daapavlov/ServoDronCAN/Паспорт.docx

| | | | | | | | ИП Воронков
| Комплект управления сервоприводом

# 1. Основные требования

  1.1 Комплект управления предназначен для взаимодействия испытателя с сервоприводом в условиях стендовых испытаний по средствам изменения положения аналоговой ручки.
  1.2 Комплект состоит из двух устройств: 1 – блок питания, который следует располагать вблизи сервопривода; 2 – пульт управления с цифровым индикатором, который следует располагать на расстоянии не более 10 м от блока питания, для дистанционного осуществления управления сервоприводом.

# 2. Технические характеристики

| Блок питания | Пульт управления
Напряжение питания постоянного тока, В | 10-36 | 5
Макс. ток потребления, А | 6 | 0.5
Интерфейс обмена данными | CAN | CAN
Интерфейс управления внешним устройством | CAN, servo PWM | -
Сигнал в измерительную систему | аналоговый 0-10 В, частотный 100-1000 Гц (открытый коллектор 10мА) | -
Защита от неправильного подключения питания | + | -

# 3. Внешний вид устройства
