daapavlov/ServoDronCAN/ServoDronCAN.png

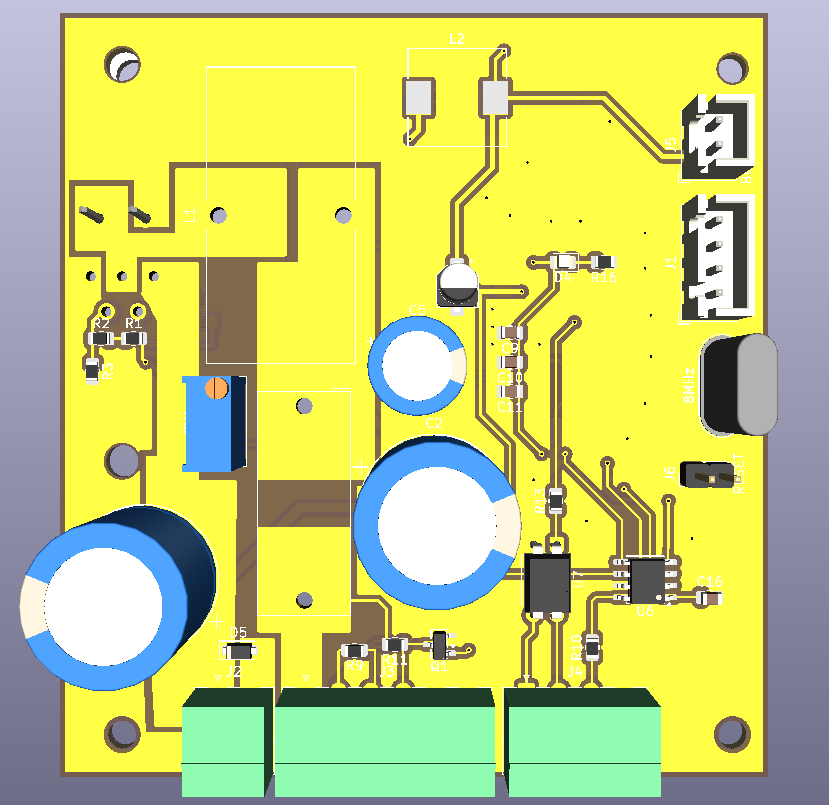
ServoDronCAN.png
