daapavlov/ServoDronCAN/Handheld remote control/Handheld remote control/2d_BUA.step

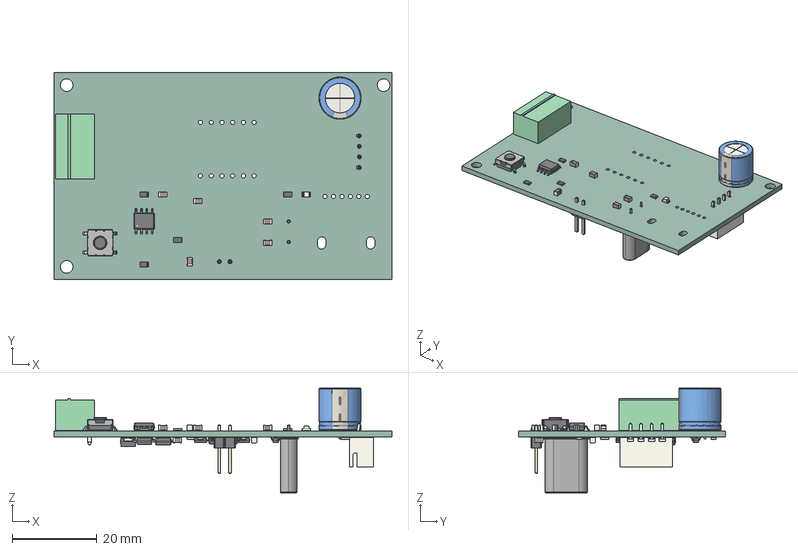
[picture p2: CAD file, 2026-10-22]
Handheld remote control/Handheld remote control/2d_BUA.step
80.0 x 49.0 x 24.8 mm
PhoenixContact_MC_1,5_4-G-3.5_1x04_P3.50mm_Horizontal
C_0805_2012Metric x 9
SW_SPST_Omron_B3FS-100xP
R_0805_2012Metric x 18
SOIC-8_3.9x4.9mm_P1.27mm
LED_0805_2012Metric
CP_Radial_D10.0mm_P2.50mm
Crystal_HC49-U_Vertical
SOT-23 x 4
D_SMB
LQFP-48_7x7mm_P0.5mm
SOIC-16_3.9x9.9mm_P1.27mm
SOT-223
PinHeader_1x02_P2.54mm_Vertical
JST_XH_B4B-XH-A_1x04_P2.50mm_Vertical
Handheld remote control_PCB
