daapavlov/ServoDronCAN/(list of files, cad)

Other CAD files:
Handheld remote control/Handheld remote control/2d_BUA.ply
Handheld remote control/Handheld remote control/2d_BUA.stl
