daapavlov/ServoDronCAN/Электрическая схема.pdf

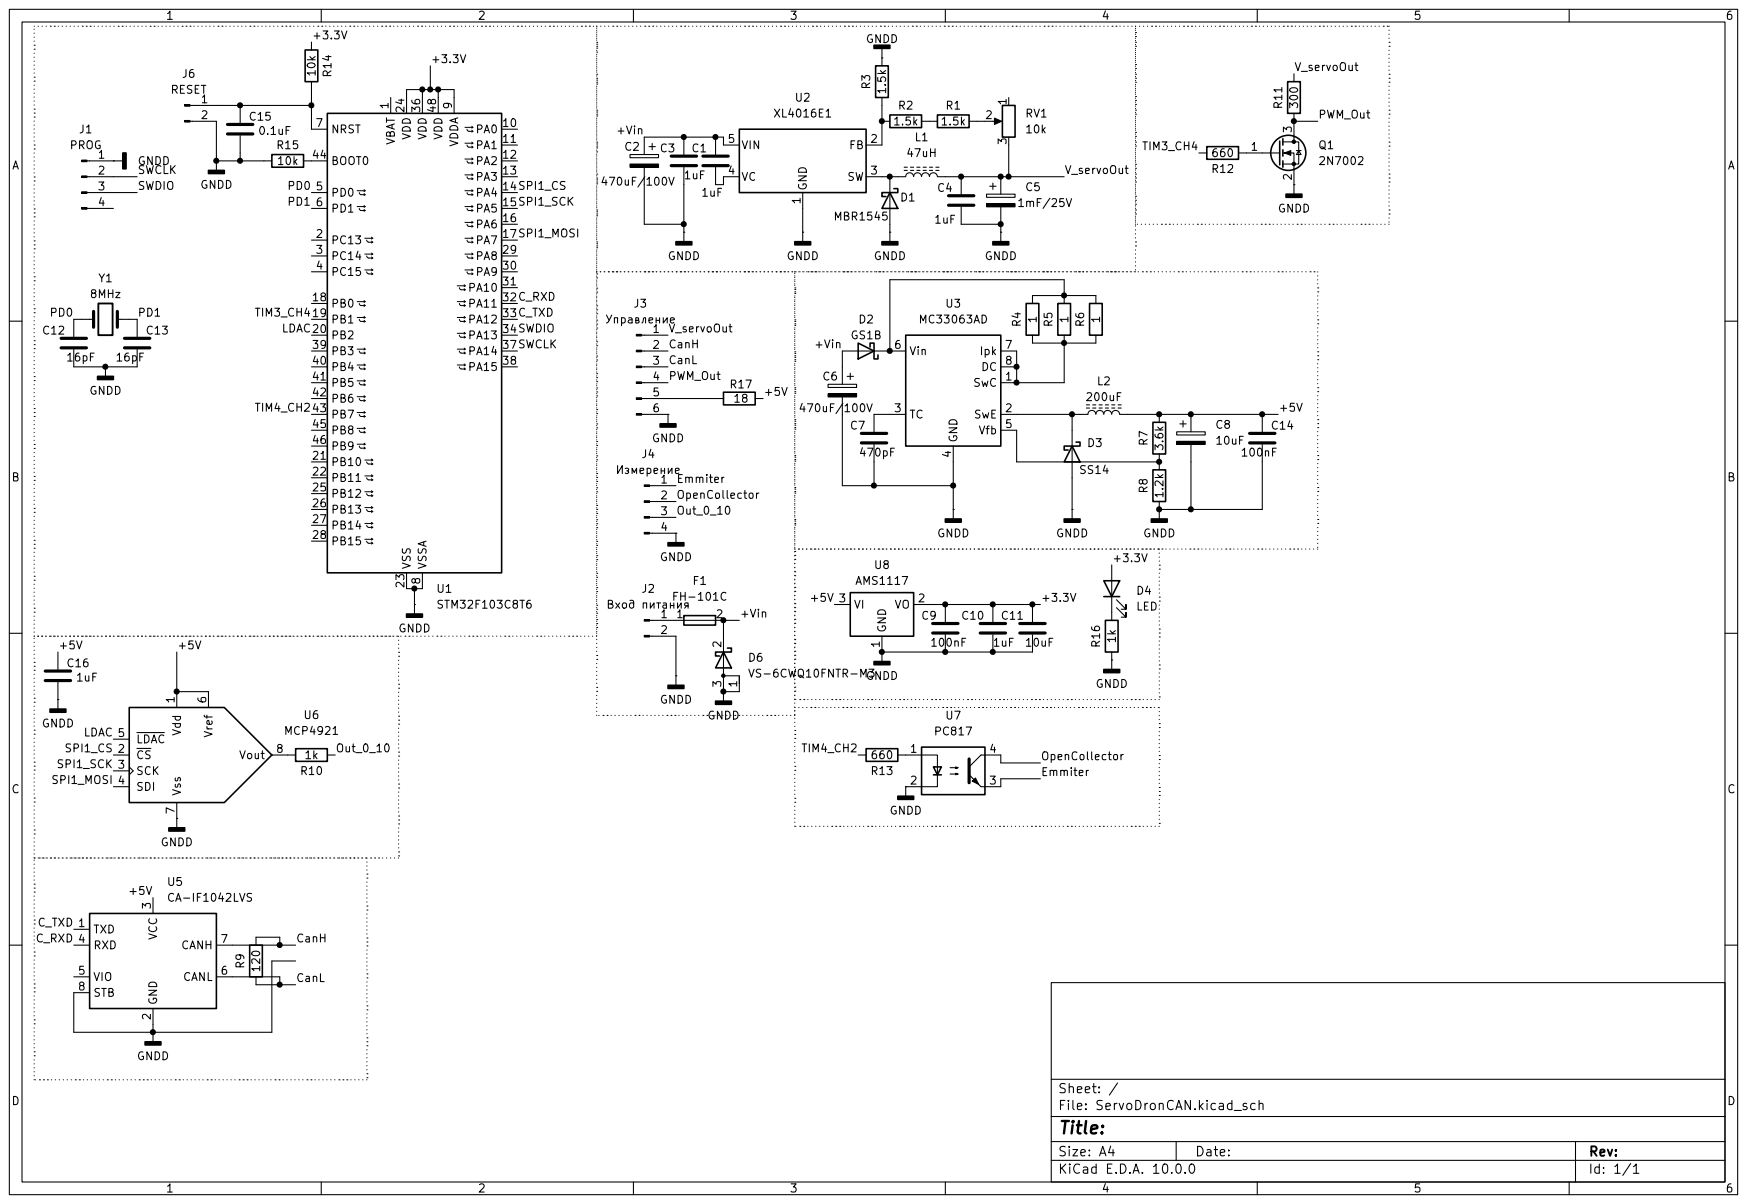
[picture p3: page 1]
