daapavlov/ServoDronCAN/ServoDronCAN/Схема электрическая БПУ.pdf

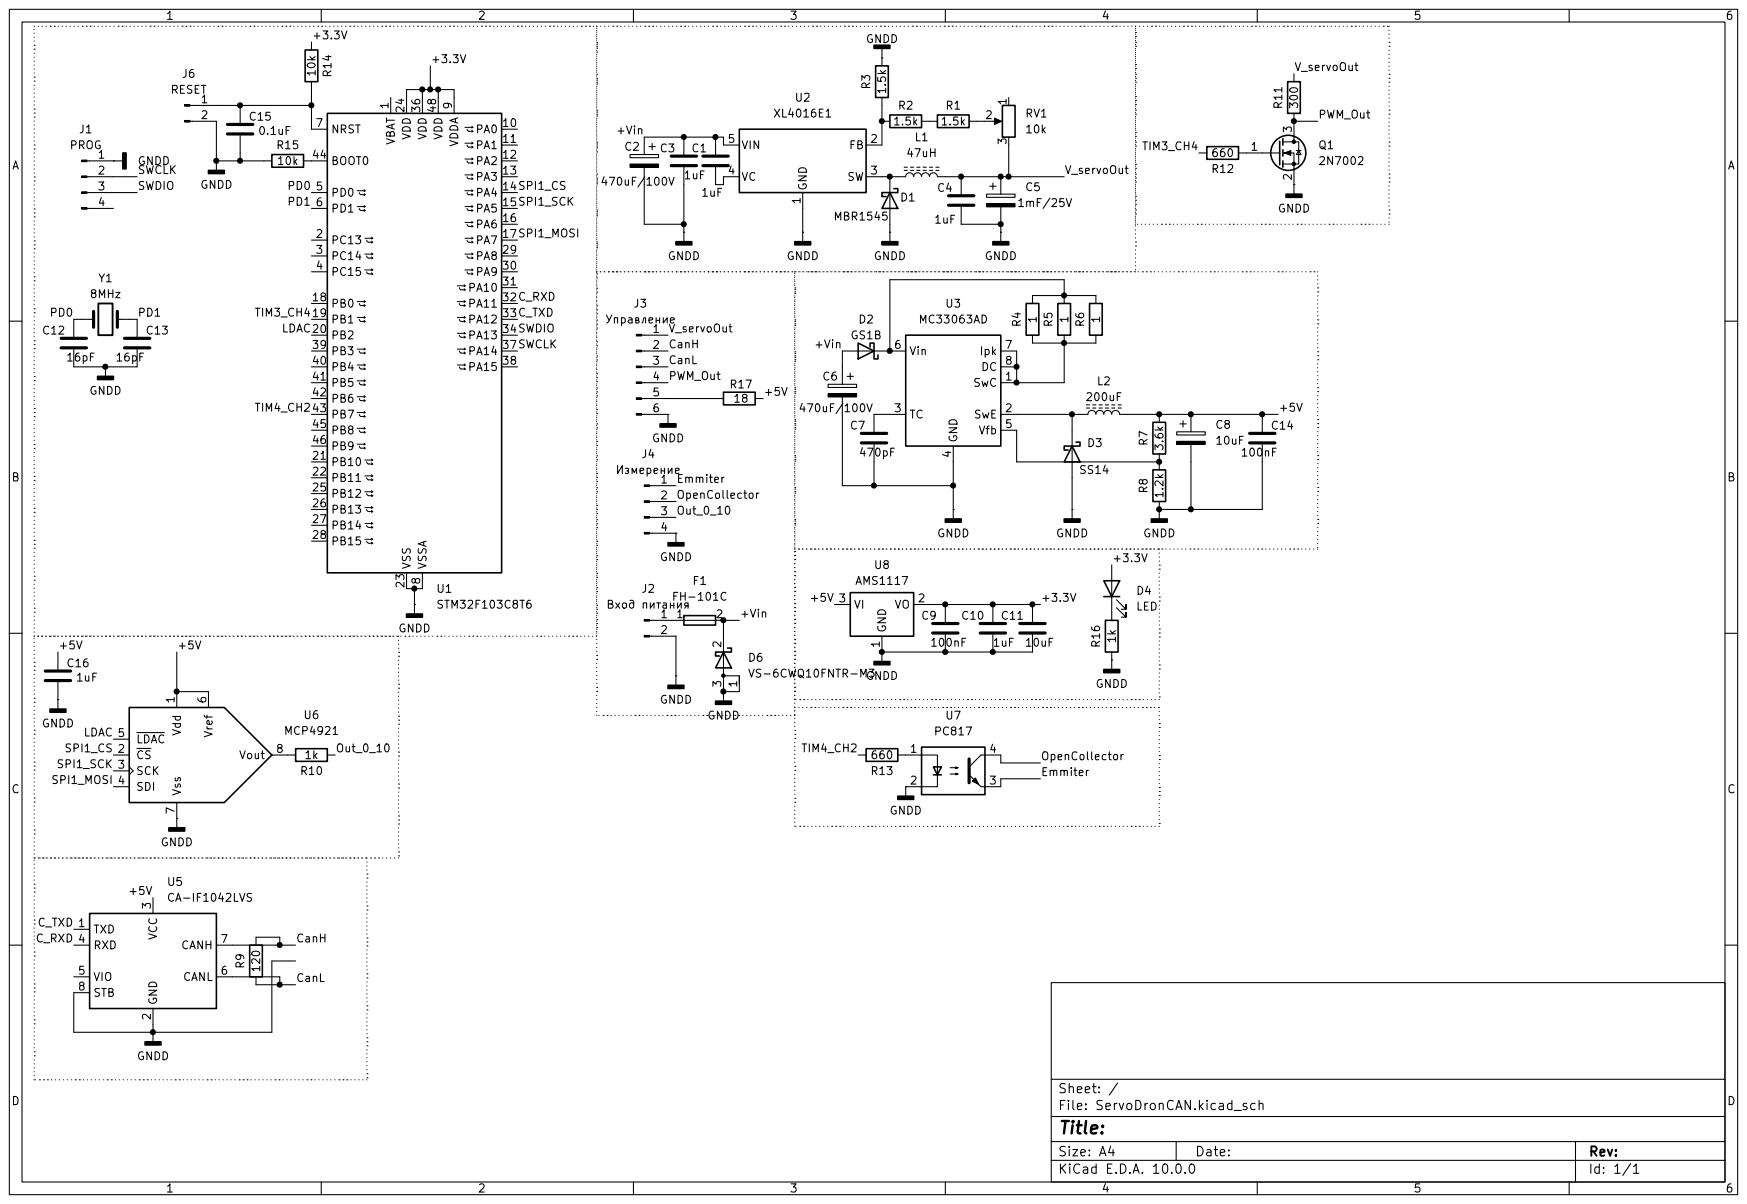
[picture p4: page 1]
