daapavlov/ServoDronCAN/Handheld remote control/Handheld remote control/Схема электрическая ПУ.pdf

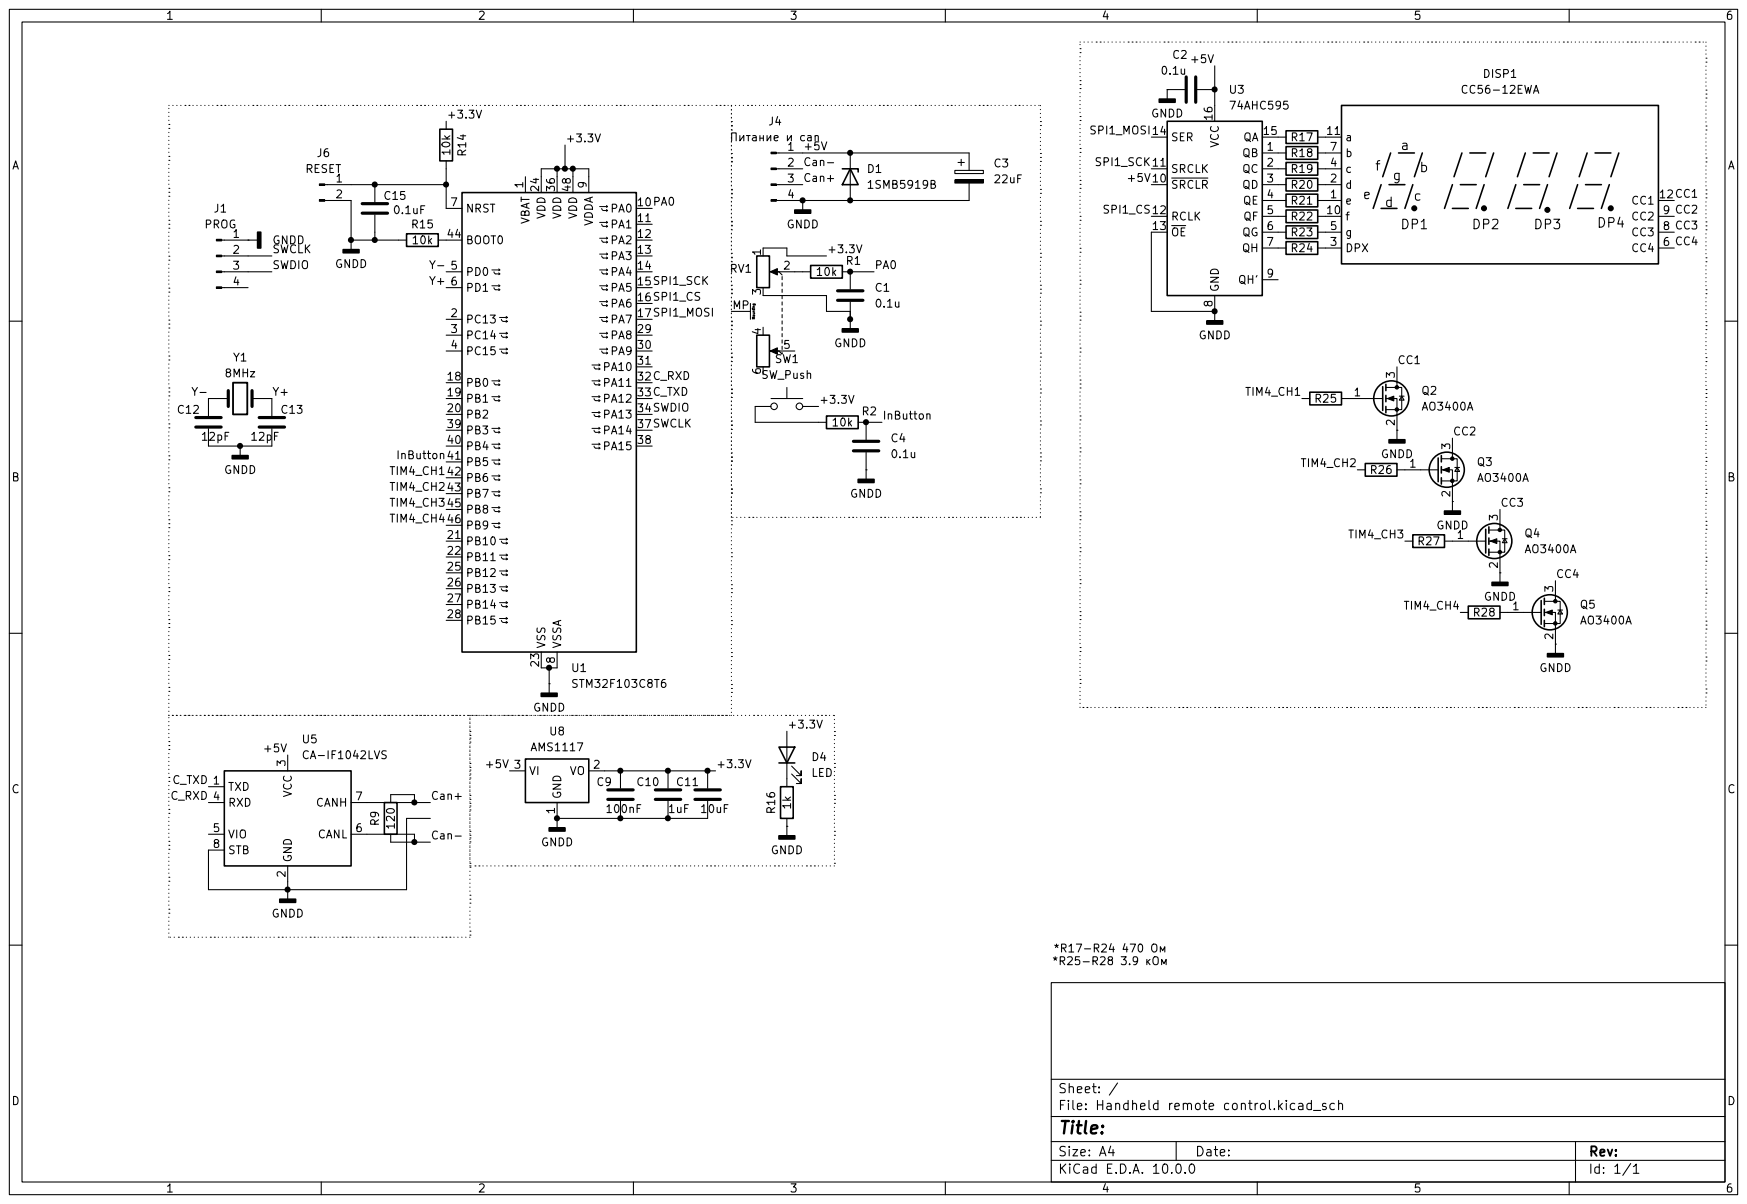
[picture p5: page 1]
