daapavlov/ServoDronCAN/Handheld remote control/Handheld remote control/Handheld remote control.kicad_pcb

## KiCad design Handheld remote control/Handheld remote control/Handheld remote control.kicad_pcb (2026-10-22)

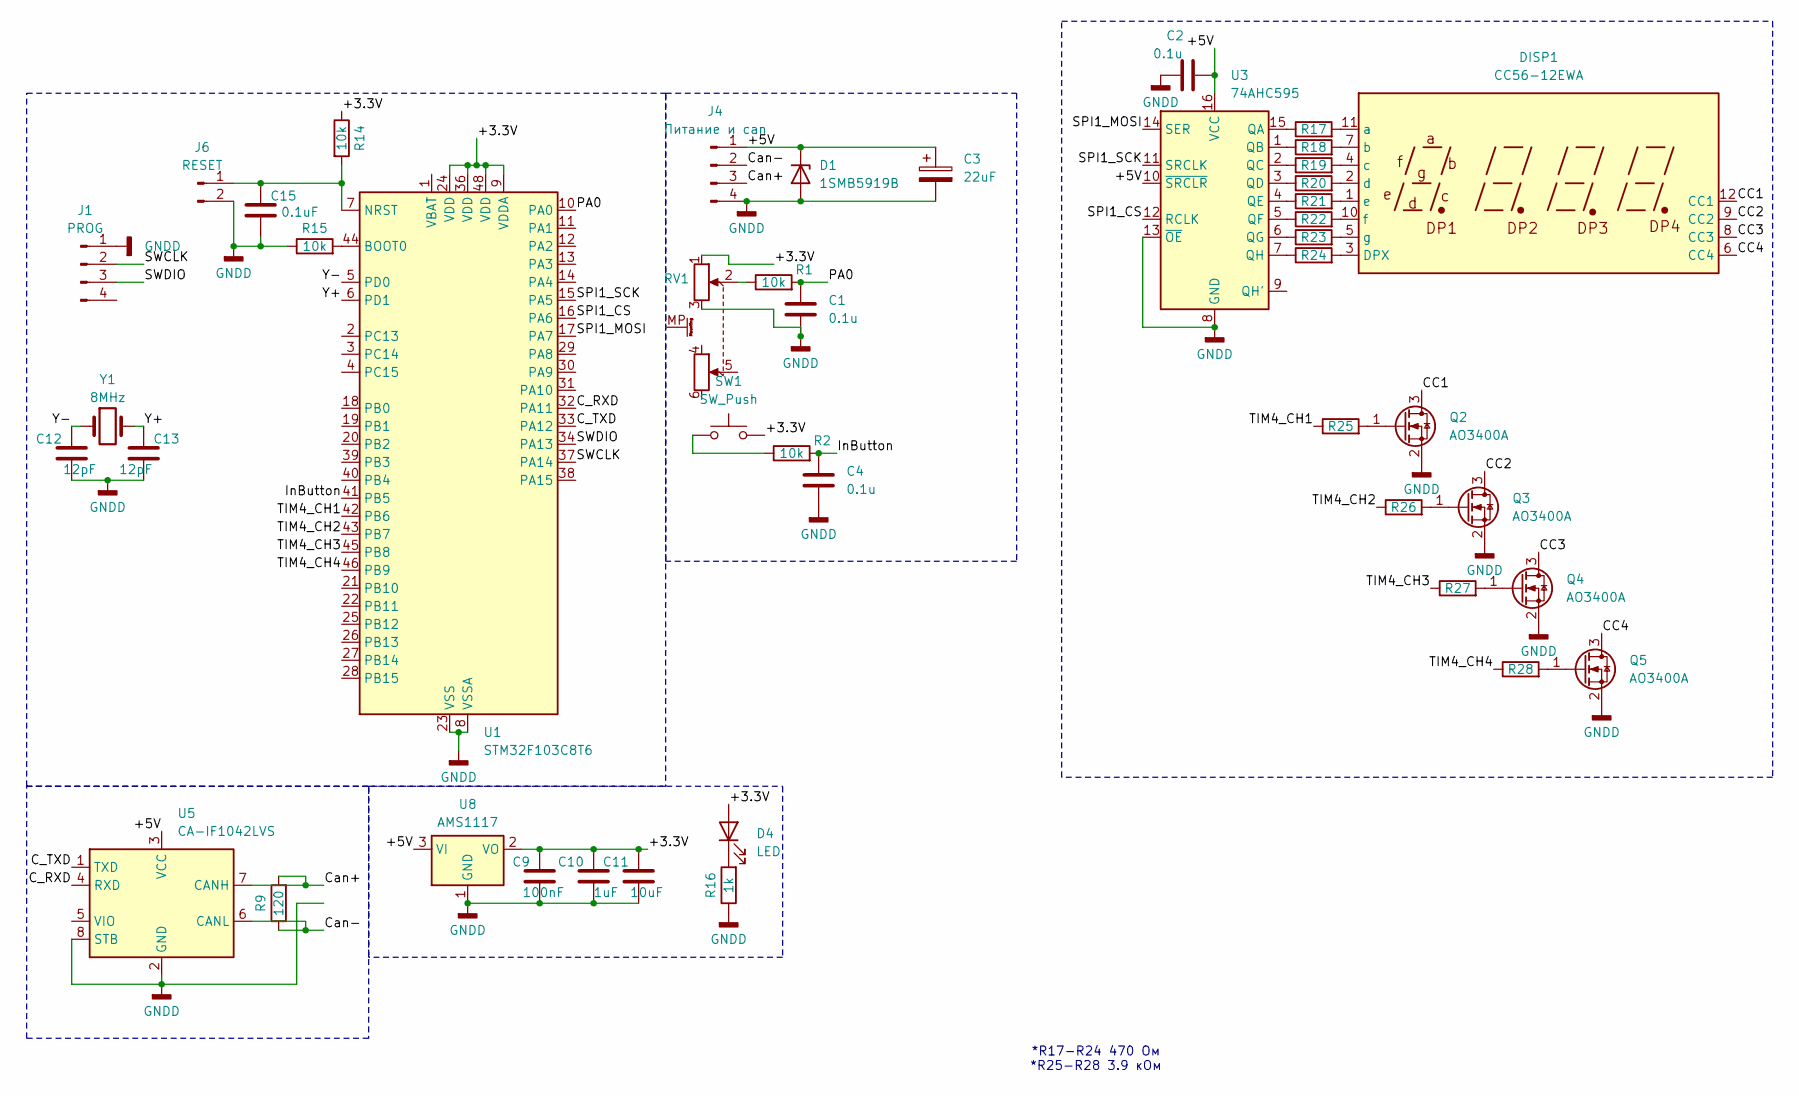
[picture p6: schematic Handheld remote control.kicad_sch]

Parts:
C1, C2, C4: 0.1u; C_0805_2012Metric_Pad1.18x1.45mm_HandSolder
C3: 22uF; CP_Radial_D10.0mm_P2.50mm
C9: 100nF; C_0805_2012Metric
C10: 1uF; C_0805_2012Metric
C11: 10uF; C_0805_2012Metric
C12, C13: 12pF; C_0805_2012Metric
C15: 0.1uF; C_0805_2012Metric
D1: 1SMB5919B; D_SMB
D4: LED; LED_0805_2012Metric
DISP1: CC56-12EWA; CA56-12EWA
J1: PROG; JST_XH_B4B-XH-A_1x04_P2.50mm_Vertical
J4: Питание и can; PhoenixContact_MC_1,5_4-G-3.5_1x04_P3.50mm_Horizontal
J6: RESET; PinHeader_1x02_P2.54mm_Vertical
Q2, Q3, Q4, Q5: AO3400A; SOT-23
R1, R2, R14, R15: 10k; R_0805_2012Metric
R9: 120; R_0805_2012Metric
R16: 1k; R_0805_2012Metric
R17, R18, R19, R20, R21, R22, R23, R24: 470; R_0805_2012Metric
R25, R26, R27, R28: 3.3k; R_0805_2012Metric
RV1: R_Potentiometer_Dual_MountingPin; Potentiometer_Bourns_PTV112-4_Dual_Vertical
SW1: SW_Push; SW_SPST_Omron_B3FS-100xP
U1: STM32F103C8T6; LQFP-48_7x7mm_P0.5mm; Operating Voltage Range 2V~3.6V; Low Voltage Detection T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 2V~3.6V; Part STM32F103C8T6; LCSC C8734
U3: 74AHC595; SOIC-16_3.9x9.9mm_P1.27mm
U5: CA-IF1042LVS; SOIC-8_3.9x4.9mm_P1.27mm
U8: AMS1117; SOT-223-3_TabPin2
Y1: 8MHz; Crystal_HC49-U_Vertical

Connections:
/+3.3V: C9.1, C10.1, C11.1, D4.2 (A), R14.1, RV1.1, SW1.2, U1.9 (VDDA), U1.24 (VDD), U1.36 (VDD), U1.48 (VDD), U8.2 (VO)
/+5V: C2.2, C3.1, D1.1 (K), J4.1, U3.10 (~SRCLR), U3.16 (VCC), U5.3 (VCC), U8.3 (VI)
/C_RXD: U1.32 (PA11), U5.4 (RXD)
/C_TXD: U1.33 (PA12), U5.1 (TXD)
/Can+: J4.3, R9.2, U5.7 (CANH)
/Can-: J4.2, R9.1, U5.6 (CANL)
/InButton: C4.1, R2.2, U1.41 (PB5)
/PA0: C1.1, R1.2, U1.10 (PA0)
/SPI1_CS: U1.16 (PA6), U3.12 (RCLK)
/SPI1_MOSI: U1.17 (PA7), U3.14 (SER)
/SPI1_SCK: U1.15 (PA5), U3.11 (SRCLK)
/SWCLK: J1.2, U1.37 (PA14)
/SWDIO: J1.3, U1.34 (PA13)
/TIM4_CH1: R25.1, U1.42 (PB6)
/TIM4_CH2: R26.1, U1.43 (PB7)
/TIM4_CH3: R27.1, U1.45 (PB8)
/TIM4_CH4: R28.1, U1.46 (PB9)
/Y+: C13.1, U1.6 (PD1), Y1.2
/Y-: C12.1, U1.5 (PD0), Y1.1
/СС1: DISP1.12 (CC1), Q2.3 (D)
/СС2: DISP1.9 (CC2), Q3.3 (D)
/СС3: DISP1.8 (CC3), Q4.3 (D)
/СС4: DISP1.6 (CC4), Q5.3 (D)
GNDD: C1.2, C2.1, C3.2, C4.2, C9.2, C10.2, C11.2, C12.2, C13.2, C15.2, D1.2 (A), J1.1, J4.4, J6.2, Q2.2 (S), Q3.2 (S), Q4.2 (S), Q5.2 (S), R15.1, R16.1, RV1.3, U1.8 (VSSA), U1.23 (VSS), U1.35 (VSS), U1.47 (VSS), U3.8 (GND), U3.13 (~OE), U5.2 (GND), U5.8 (STB), U8.1 (GND)
unnamed: D4.1 (K), R16.2
unnamed: DISP1.3 (DPX), R24.2
unnamed: DISP1.11 (a), R17.2
unnamed: DISP1.7 (b), R18.2
unnamed: DISP1.4 (c), R19.2
unnamed: DISP1.2 (d), R20.2
unnamed: DISP1.1 (e), R21.2
unnamed: DISP1.10 (f), R22.2
unnamed: DISP1.5 (g), R23.2
unnamed: C15.1, J6.1, R14.2, U1.7 (NRST)
unnamed: Q2.1 (G), R25.2
unnamed: Q3.1 (G), R26.2
unnamed: Q4.1 (G), R27.2
unnamed: Q5.1 (G), R28.2
unnamed: R1.1, RV1.2
unnamed: R2.1, SW1.1
unnamed: R15.2, U1.44 (BOOT0)
unnamed: R17.1, U3.15 (QA)
unnamed: R18.1, U3.1 (QB)
unnamed: R19.1, U3.2 (QC)
unnamed: R20.1, U3.3 (QD)
unnamed: R21.1, U3.4 (QE)
unnamed: R22.1, U3.5 (QF)
unnamed: R23.1, U3.6 (QG)
unnamed: R24.1, U3.7 (QH)

Notes on the sheet:
*R17-R24 470 Ом *R25-R28 3.9 кОм

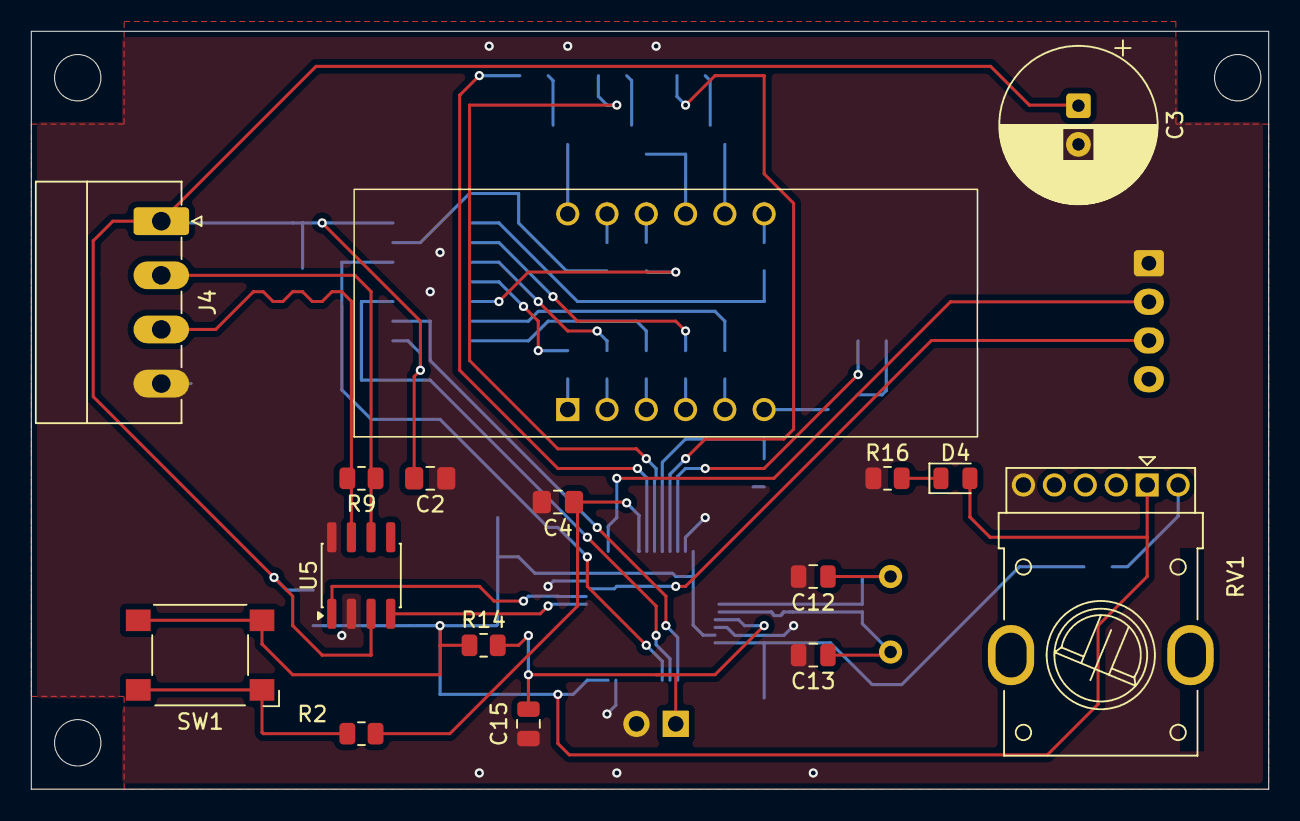
[picture p7: board Handheld remote control.kicad_pcb from above]

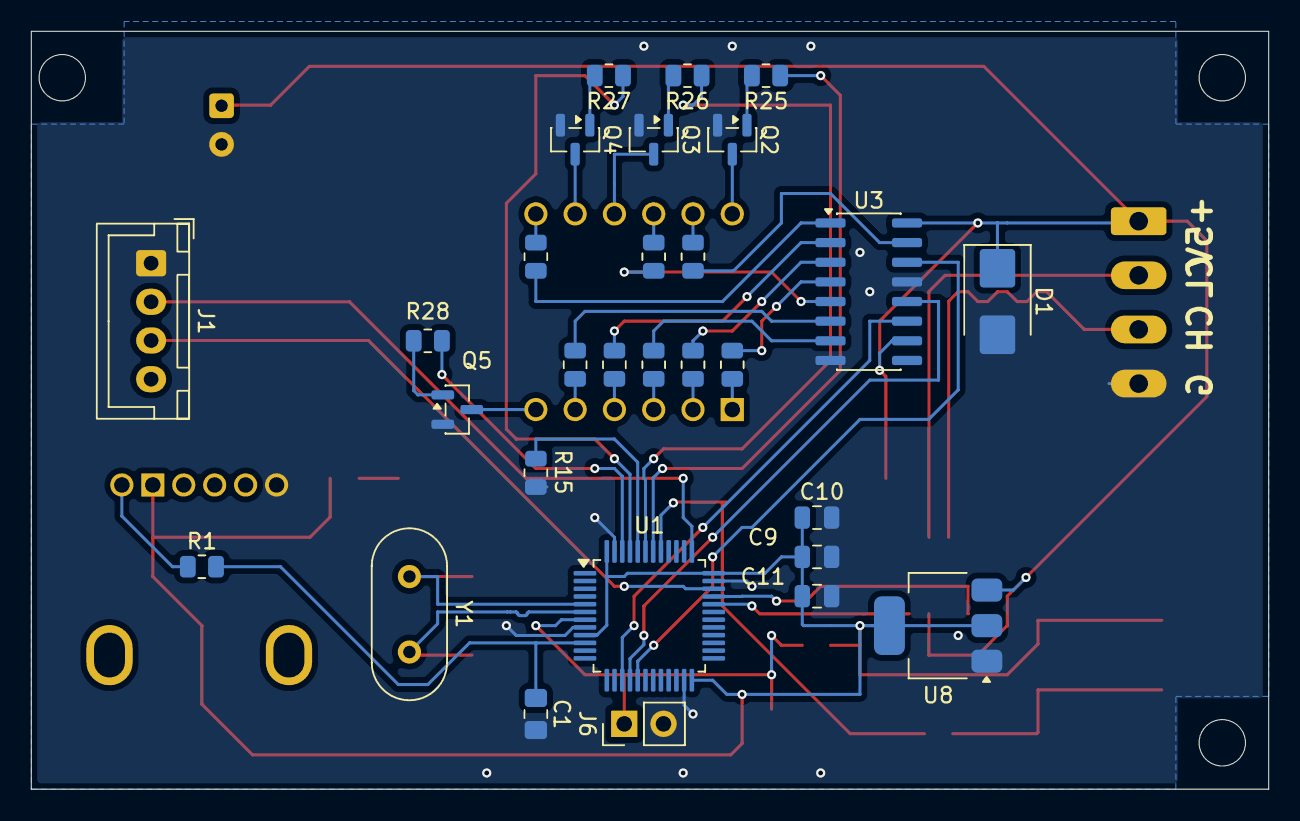
[picture p8: board Handheld remote control.kicad_pcb from below]

Board: 2 copper layers, 80.0 x 49.0 mm, 45 parts (29 on the bottom side), 49 nets.
