daapavlov/ServoDronCAN/ServoDronCAN/ServoDronCAN.kicad_pcb

## KiCad design ServoDronCAN/ServoDronCAN.kicad_pcb (2026-09-30)

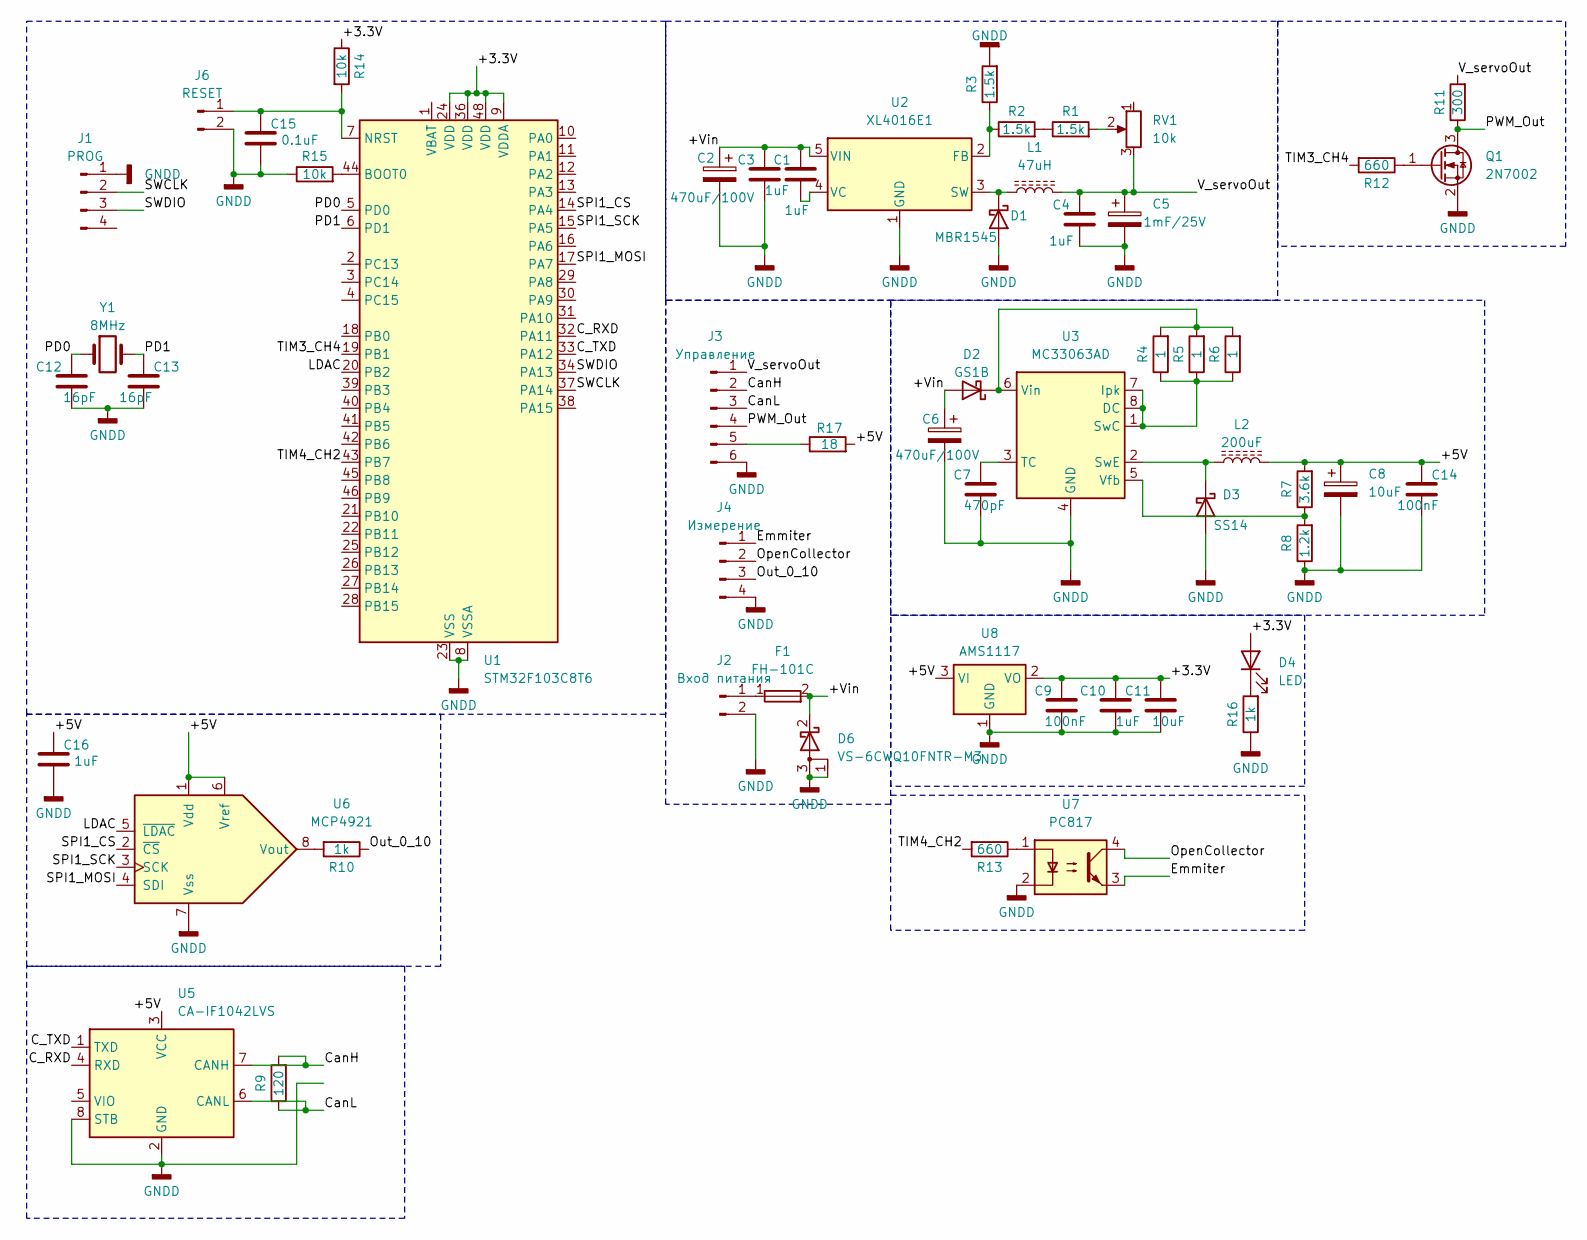
[picture p9: schematic ServoDronCAN.kicad_sch]

Parts:
C1, C3, C4, C10, C16: 1uF; C_0805_2012Metric
C2, C6: 470uF/100V; CP_Radial_D16.0mm_P7.50mm
C5: 1mF/25V; CP_Radial_D10.0mm_P5.00mm
C7: 470pF; C_0805_2012Metric
C8: 10uF; CP_Elec_4x5.4
C9, C14: 100nF; C_0805_2012Metric
C11: 10uF; C_0805_2012Metric
C12, C13: 16pF; C_0805_2012Metric
C15: 0.1uF; C_0805_2012Metric
D1: MBR1545; TO-220-2_Horizontal_TabUp
D2: GS1B; D_SMA
D3: SS14; D_SMA
D4: LED; LED_0805_2012Metric
D6: VS-6CWQ10FNTR-M3; TO-252-2
F1: FH-101C
J1: PROG; JST_XH_B4B-XH-A_1x04_P2.50mm_Vertical
J2: Вход питания; PhoenixContact_MC_1,5_2-G-3.5_1x02_P3.50mm_Horizontal
J3: Управление; PhoenixContact_MC_1,5_6-G-3.5_1x06_P3.50mm_Horizontal
J4: Измерение; PhoenixContact_MC_1,5_4-G-3.5_1x04_P3.50mm_Horizontal
J6: RESET; PinHeader_1x02_P2.54mm_Vertical
L1: 47uH; L_Toroid_Vertical_L31.8mm_W15.9mm_P13.50mm_Bourns_5700
L2: 200uF; L_10.4x10.4_H4.8
Q1: 2N7002; SOT-23-3
R1, R2, R3: 1.5k; R_0805_2012Metric
R4, R5, R6: 1; R_0805_2012Metric
R7: 3.6k; R_0805_2012Metric
R8: 1.2k; R_0805_2012Metric
R9: 120; R_0805_2012Metric
R10, R16: 1k; R_0805_2012Metric
R11: 300; R_0805_2012Metric
R12, R13: 660; R_0805_2012Metric
R14, R15: 10k; R_0805_2012Metric
R17: 18; R_Axial_DIN0516_L15.5mm_D5.0mm_P20.32mm_Horizontal
RV1: 10k; Potentiometer_Bourns_3296W_Vertical
U1: STM32F103C8T6; LQFP-48_7x7mm_P0.5mm; Operating Voltage Range 2V~3.6V; Low Voltage Detection T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 2V~3.6V; Part STM32F103C8T6; LCSC C8734
U2: XL4016E1; TO-220-5_P3.4x3.8mm_StaggerOdd_Lead7.13mm_TabDown
U3: MC33063AD; SOIC-8_3.9x4.9mm_P1.27mm
U5: CA-IF1042LVS; SOIC-8_3.9x4.9mm_P1.27mm
U6: MCP4921; SOIC-8_3.9x4.9mm_P1.27mm
U7: PC817; DIP-4_W7.62mm
U8: AMS1117; SOT-223-3_TabPin2
Y1: 8MHz; Crystal_HC49-U_Vertical

Connections:
/+3.3V: C9.1, C10.1, C11.1, D4.2 (A), R14.1, U1.9 (VDDA), U1.24 (VDD), U1.36 (VDD), U1.48 (VDD), U8.2 (VO)
/+5V: C8.1, C14.1, C16.1, J3.5, L2.2, R7.2, R17.1, R17.2, U5.3 (VCC), U6.1 (Vdd), U6.6 (Vref), U8.3 (VI)
/+Vin: C1.1, C2.1, C3.1, C6.1, D2.2 (A), D6.2 (K), F1.2, U2.5 (VIN)
/C_RXD: U1.32 (PA11), U5.4 (RXD)
/C_TXD: U1.33 (PA12), U5.1 (TXD)
/CanH: J3.2, R9.2, U5.7 (CANH)
/CanL: J3.3, R9.1, U5.6 (CANL)
/Emmiter: J4.1, U7.3
/LDAC: U1.20 (PB2), U6.5 (~LDAC)
/OpenCollector: J4.2, U7.4
/Out_0_10: J4.3, R10.1
/PD0: C12.1, U1.5 (PD0), Y1.1
/PD1: C13.1, U1.6 (PD1), Y1.2
/PWM_Out: J3.4, Q1.3 (D), R11.1
/SPI1_CS: U1.14 (PA4), U6.2 (~CS)
/SPI1_MOSI: U1.17 (PA7), U6.4 (SDI)
/SPI1_SCK: U1.15 (PA5), U6.3 (SCK)
/SWCLK: J1.2, U1.37 (PA14)
/SWDIO: J1.3, U1.34 (PA13)
/TIM3_CH4: R12.2, U1.19 (PB1)
/TIM4_CH2: R13.2, U1.43 (PB7)
/V_servoOut: C4.1, C5.1, J3.1, L1.2, R11.2, RV1.3
GNDD: C2.2, C3.2, C4.2, C5.2, C6.2, C7.2, C8.2, C9.2, C10.2, C11.2, C12.2, C13.2, C14.2, C15.2, C16.2, D1.2 (A), D3.2 (A), D6.1 (A), D6.3 (A), J1.1, J2.2, J3.6, J4.4, J6.2, Q1.2 (S), R3.2, R8.1, R15.1, R16.1, U1.8 (VSSA), U1.23 (VSS), U1.35 (VSS), U1.47 (VSS), U2.1 (GND), U3.4 (GND), U5.2 (GND), U5.8 (STB), U6.7 (Vss), U7.2, U8.1 (GND)
unnamed: D1.1 (K), L1.1, U2.3 (SW)
unnamed: D2.1 (K), R4.2, R5.2, R6.2, U3.6 (Vin)
unnamed: D3.1 (K), L2.1, U3.2 (SwE)
unnamed: D4.1 (K), R16.2
unnamed: F1.1, J2.1
unnamed: C15.1, J6.1, R14.2, U1.7 (NRST)
unnamed: Q1.1 (G), R12.1
unnamed: R1.1, R2.2
unnamed: R1.2, RV1.2
unnamed: R13.1, U7.1
unnamed: R15.2, U1.44 (BOOT0)
unnamed: R2.1, R3.1, U2.2 (FB)
unnamed: C1.2, U2.4 (VC)
unnamed: R4.1, R5.1, R6.1, U3.1 (SwC), U3.7 (Ipk), U3.8 (DC)
unnamed: C7.1, U3.3 (TC)
unnamed: R7.1, R8.2, U3.5 (Vfb)
unnamed: R10.2, U6.8 (Vout)

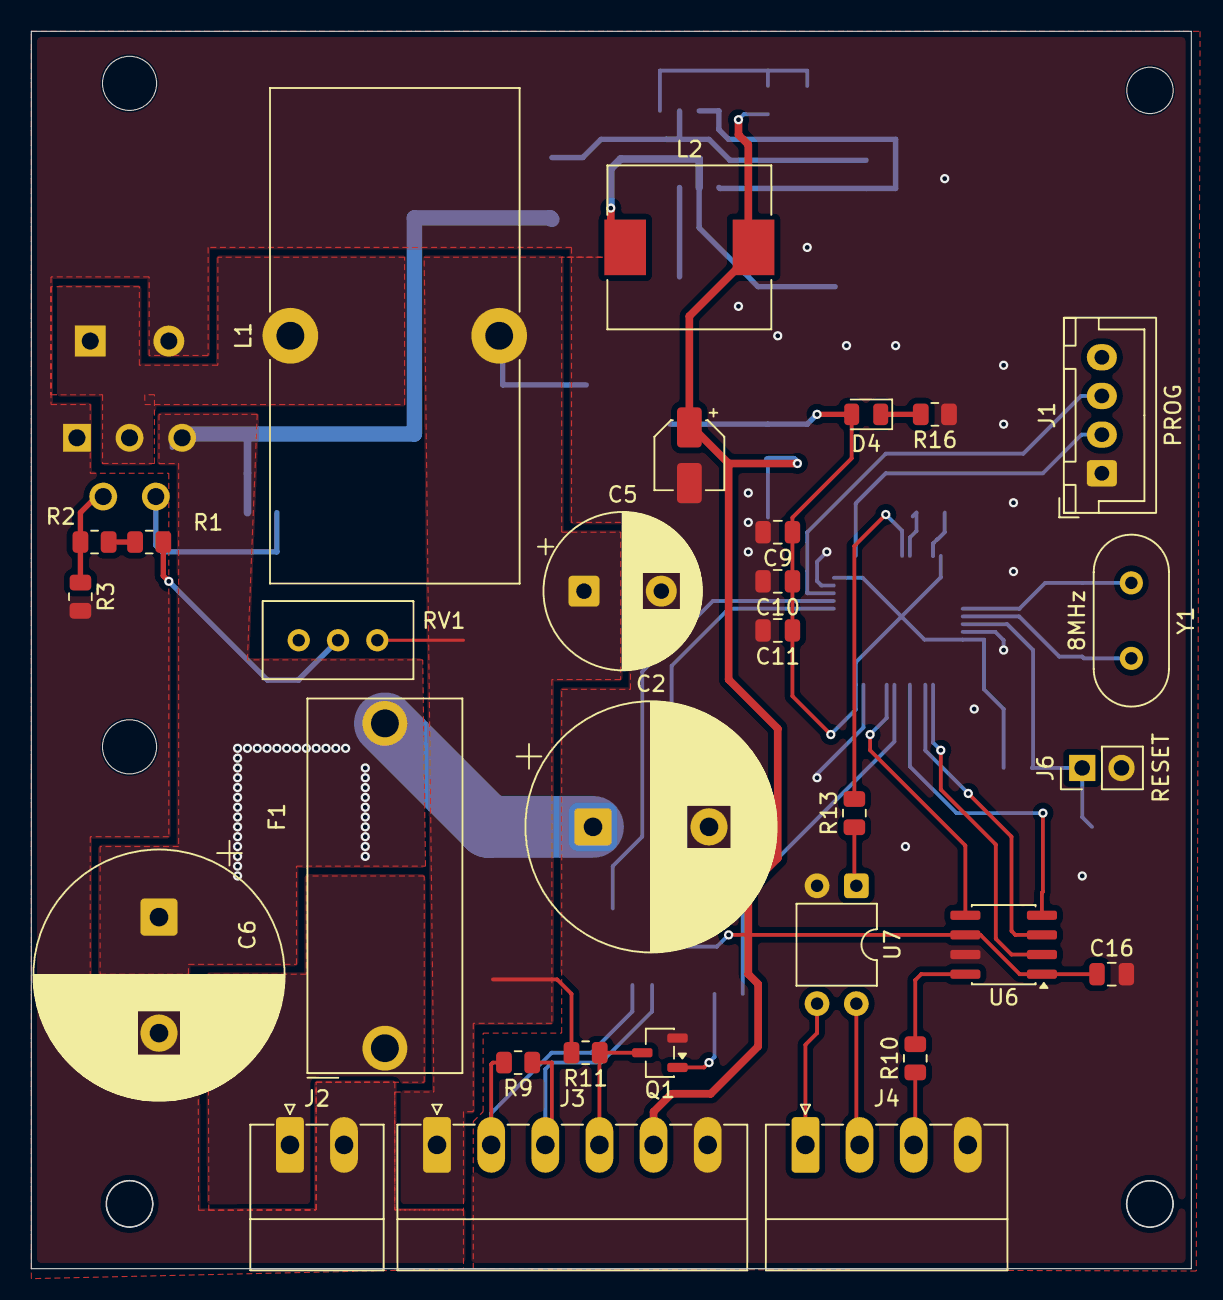
[picture p10: board ServoDronCAN.kicad_pcb from above]

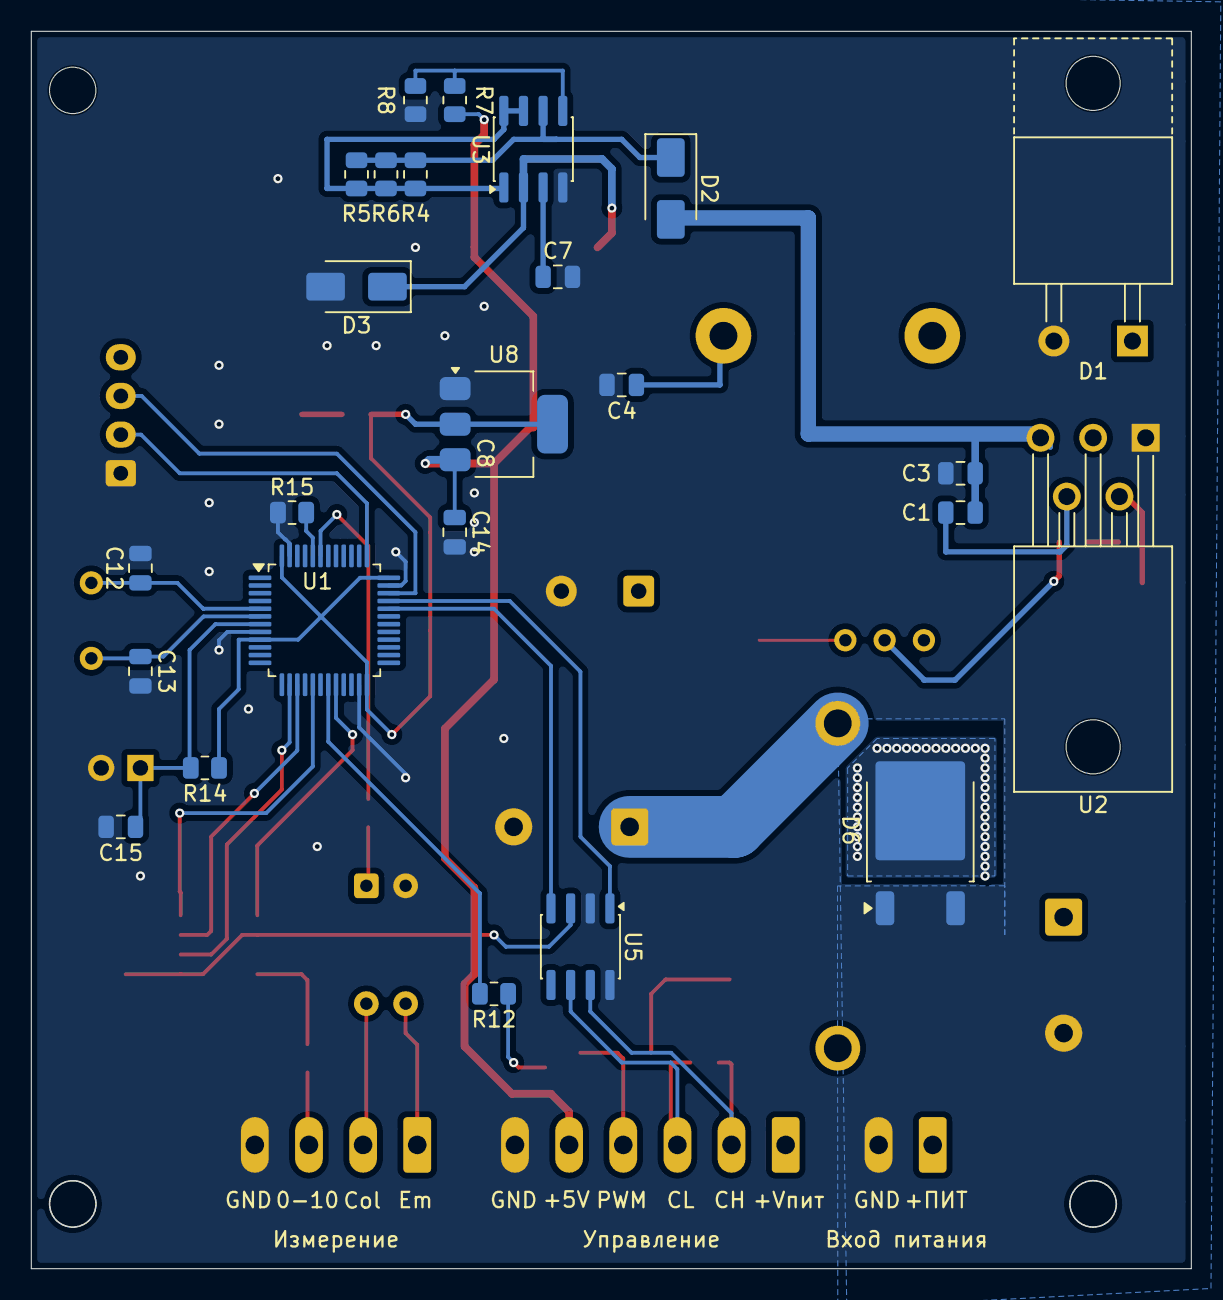
[picture p11: board ServoDronCAN.kicad_pcb from below]

Board: 2 copper layers, 75.0 x 80.0 mm, 55 parts (25 on the bottom side), 40 nets.
