daapavlov/ServoDronCAN/(commit log)

2026-09-17 Электрическая схема питание 0-36В, выход токовый на сервомашинку 6А. Управление CAN и PWM, выход 0-10В и откытый коллектор до 50мА 60В
2026-09-21 Доработана электрическая схема (изменен частотный выход, добавлен разъем для питания вентилтора. Создана печатная плата с расположением компонентов.
2026-09-30 Исправлена электрическая схема. Добвлена защита от переполюсовки и предохранитель от превышение потребляемоготока (6А). Создан гербер файл для производства.
2026-10-22 Закончен этап. Две программы для БПУ и ПЗ. Присутствует реверс положения.
2026-10-23 Убрана функция инвертирования сигнала. Добавлена функция выбора минимального и максимального положения залонки
